AlexeyRevinski/RICNU_HLCI_board/RICNU_Plan_v_1_0.kicad_pcb

## KiCad design RICNU_Plan_v_1_0.kicad_pcb (2018-02-20)

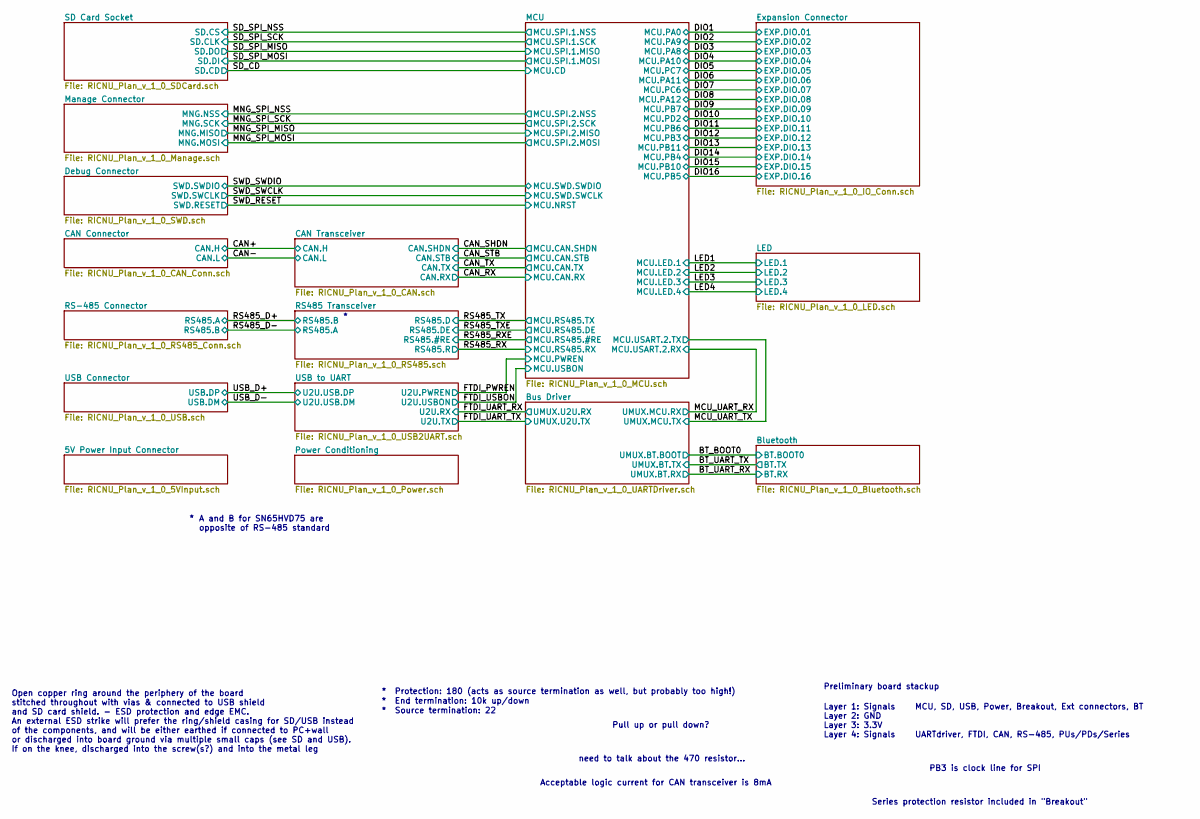
[picture p1: schematic RICNU_Plan_v_1_0.sch, RICNU Plan - Main]

Notes on the sheet:
Pull up or pull down?
* Protection: 180 (acts as source termination as well, but probably too high!)
* End termination: 10k up/down
* Source termination: 22
Acceptable logic current for CAN transceiver is 8mA
Series protection resistor included in "Breakout"
need to talk about the 470 resistor...
Open copper ring around the periphery of the board stitched throughout with vias & connected to USB shield and SD card shield. - ESD protection and edge EMC. An external ESD strike will prefer the ring/shield casing for SD/USB instead of the components, and will be either earthed if connected to PC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
PB3 is clock line for SPI
Layer 1: Signals Layer 2: GND Layer 3: 3.3V Layer 4: Signals
MCU, SD, USB, Power, Breakout, Ext connectors, BT UARTdriver, FTDI, CAN, RS-485, PUs/PDs/Series
Preliminary board stackup
A and B for SN65HVD75 are opposite of RS-485 standard

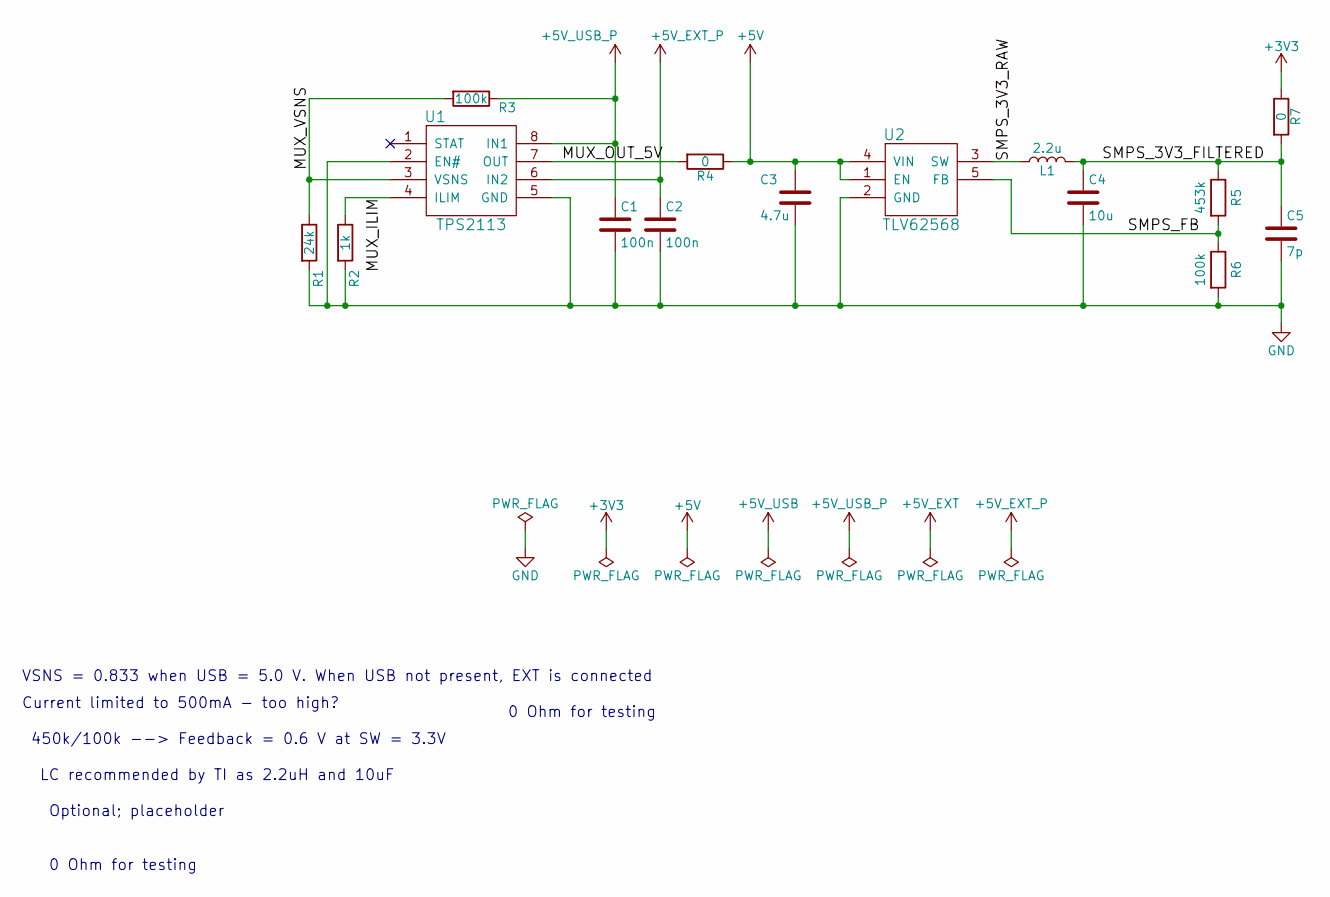
[picture p2: schematic RICNU_Plan_v_1_0_Power.sch, RICNU Plan - Main]

Parts:
C1, C2: 100n; C_0402_NoSilk
C3: 4.7u; C_0805
C4: 10u; C_0805
C5: 7p; C_0402_NoSilk
L1: 2.2u; L_Taiyo-Yuden_NR-50xx_HandSoldering
R1: 24k; R_0402_NoSilk
R2: 1k; R_0402_NoSilk
R3, R6: 100k; R_0402_NoSilk
R4, R7: 0; R_0402_NoSilk
R5: 453k; R_0402_NoSilk
U1: TPS2113; TSSOP-8_4.4x3mm_Pitch0.65mm
U2: TLV62568; SOT-23-5

Connections:
+3V3: R7.1; also elsewhere on the board
+5V: C3.1, R4.1, U2.1 (EN), U2.4 (VIN)
+5V_EXT_P: C2.1, U1.6 (IN2); also elsewhere on the board
+5V_USB_P: C1.1, R3.1, U1.8 (IN1); also elsewhere on the board
/Power Conditioning/MUX_ILIM: R2.1, U1.4 (ILIM)
/Power Conditioning/MUX_OUT_5V: R4.2, U1.7 (OUT)
/Power Conditioning/MUX_VSNS: R1.1, R3.2, U1.3 (VSNS)
/Power Conditioning/SMPS_3V3_FILTERED: C4.1, C5.1, L1.2, R5.1, R7.2
/Power Conditioning/SMPS_3V3_RAW: L1.1, U2.3 (SW)
/Power Conditioning/SMPS_FB: R5.2, R6.1, U2.5 (FB)
GND: C1.2, C2.2, C3.2, C4.2, C5.2, R1.2, R2.2, R6.2, U1.2 (EN#), U1.5 (GND), U2.2 (GND); also elsewhere on the board

Notes on the sheet:
0 Ohm for testing
450k/100k --> Feedback = 0.6 V at SW = 3.3V
LC recommended by TI as 2.2uH and 10uF
Optional; placeholder
VSNS = 0.833 when USB = 5.0 V. When USB not present, EXT is connected
Current limited to 500mA - too high?

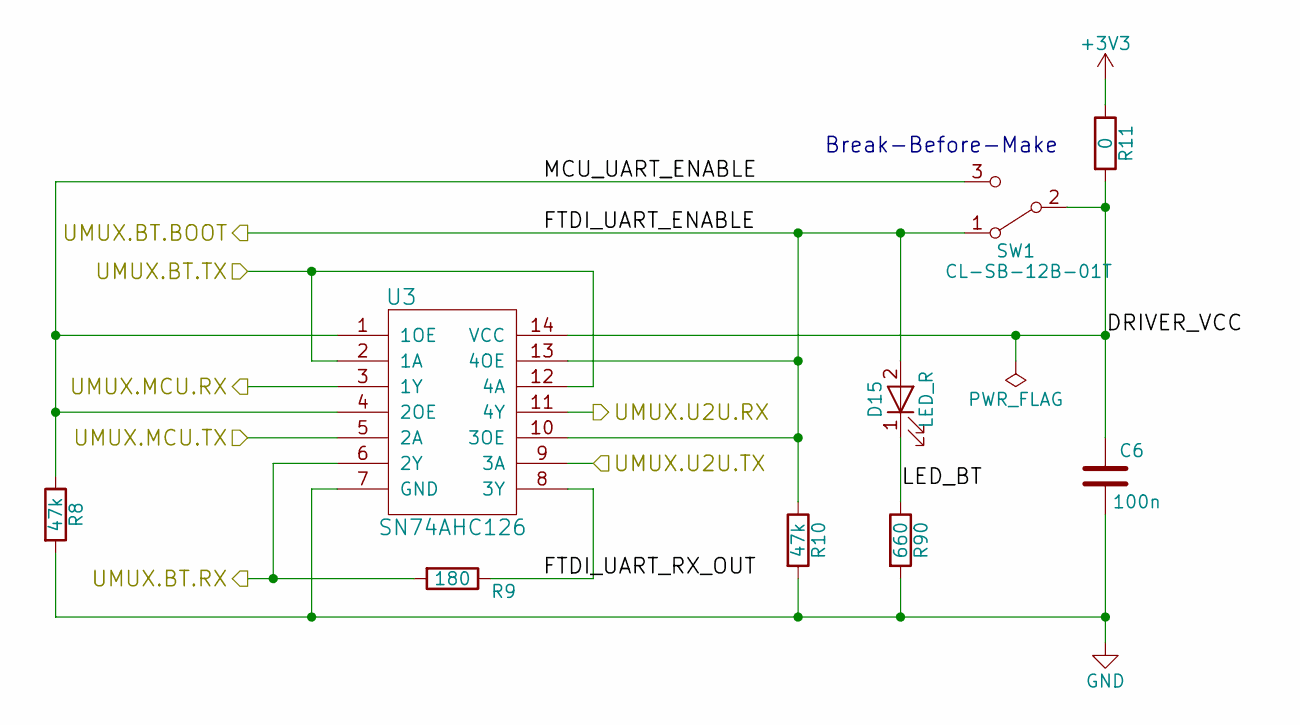
[picture p3: schematic RICNU_Plan_v_1_0_UARTDriver.sch, RICNU Plan - Main]

Parts:
C6: 100n; C_0402_NoSilk
D15: LED_R; LED_0402
R8, R10: 47k; R_0402_NoSilk
R9: 180; R_0402_NoSilk
R11: 0; R_0402_NoSilk
R90: 660; R_0402_NoSilk
SW1: CL-SB-12B-01T
U3: SN74AHC126; TSSOP-14_4.4x5mm_Pitch0.65mm

Connections:
+3V3: R11.1; also elsewhere on the board
/BT_BOOT0: D15.2 (A), R10.1, SW1.1 (A), U3.10 (3OE), U3.13 (4OE); also elsewhere on the board
/BT_UART_RX: R9.2, U3.6 (2Y); also elsewhere on the board
/BT_UART_TX: U3.2 (1A), U3.12 (4A); also elsewhere on the board
/Bus Driver/DRIVER_VCC: C6.1, R11.2, SW1.2 (B), U3.14 (VCC)
/Bus Driver/FTDI_UART_RX_OUT: R9.1, U3.8 (3Y)
/Bus Driver/LED_BT: D15.1 (K), R90.1
/Bus Driver/MCU_UART_ENABLE: R8.1, SW1.3 (C), U3.1 (1OE), U3.4 (2OE)
/FTDI_UART_RX: U3.11 (4Y); also elsewhere on the board
/FTDI_UART_TX: U3.9 (3A); also elsewhere on the board
/MCU_UART_RX: U3.3 (1Y); also elsewhere on the board
/MCU_UART_TX: U3.5 (2A); also elsewhere on the board
GND: C6.2, R8.2, R10.2, R90.2, U3.7 (GND); also elsewhere on the board

Notes on the sheet:
Break-Before-Make

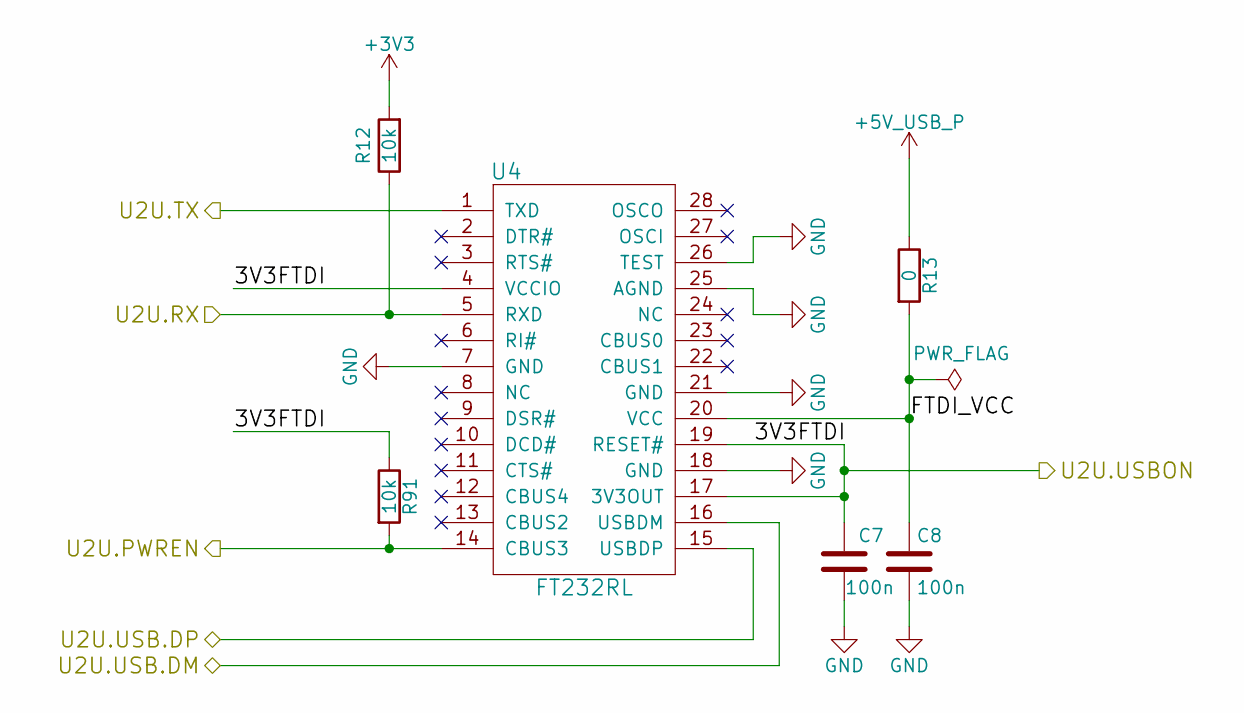
[picture p4: schematic RICNU_Plan_v_1_0_USB2UART.sch, RICNU Plan - Main]

Parts:
C7, C8: 100n; C_0402_NoSilk
R12, R91: 10k; R_0402_NoSilk
R13: 0; R_0402_NoSilk
U4: FT232RL; SSOP-28_5.3x10.2mm_Pitch0.65mm

Connections:
+3V3: R12.2; also elsewhere on the board
+5V_USB_P: R13.1; also elsewhere on the board
/FTDI_PWREN: R91.2, U4.14 (CBUS3); also elsewhere on the board
/FTDI_UART_RX: R12.1, U4.5 (RXD); also elsewhere on the board
/FTDI_UART_TX: U4.1 (TXD); also elsewhere on the board
/FTDI_USBON: C7.1, R91.1, U4.4 (VCCIO), U4.17 (3V3OUT), U4.19 (RESET#); also elsewhere on the board
/USB to UART/FTDI_VCC: C8.1, R13.2, U4.20 (VCC)
/USB_D+: U4.15 (USBDP); also elsewhere on the board
/USB_D-: U4.16 (USBDM); also elsewhere on the board
GND: C7.2, C8.2, U4.7 (GND), U4.18 (GND), U4.21 (GND), U4.25 (AGND), U4.26 (TEST); also elsewhere on the board

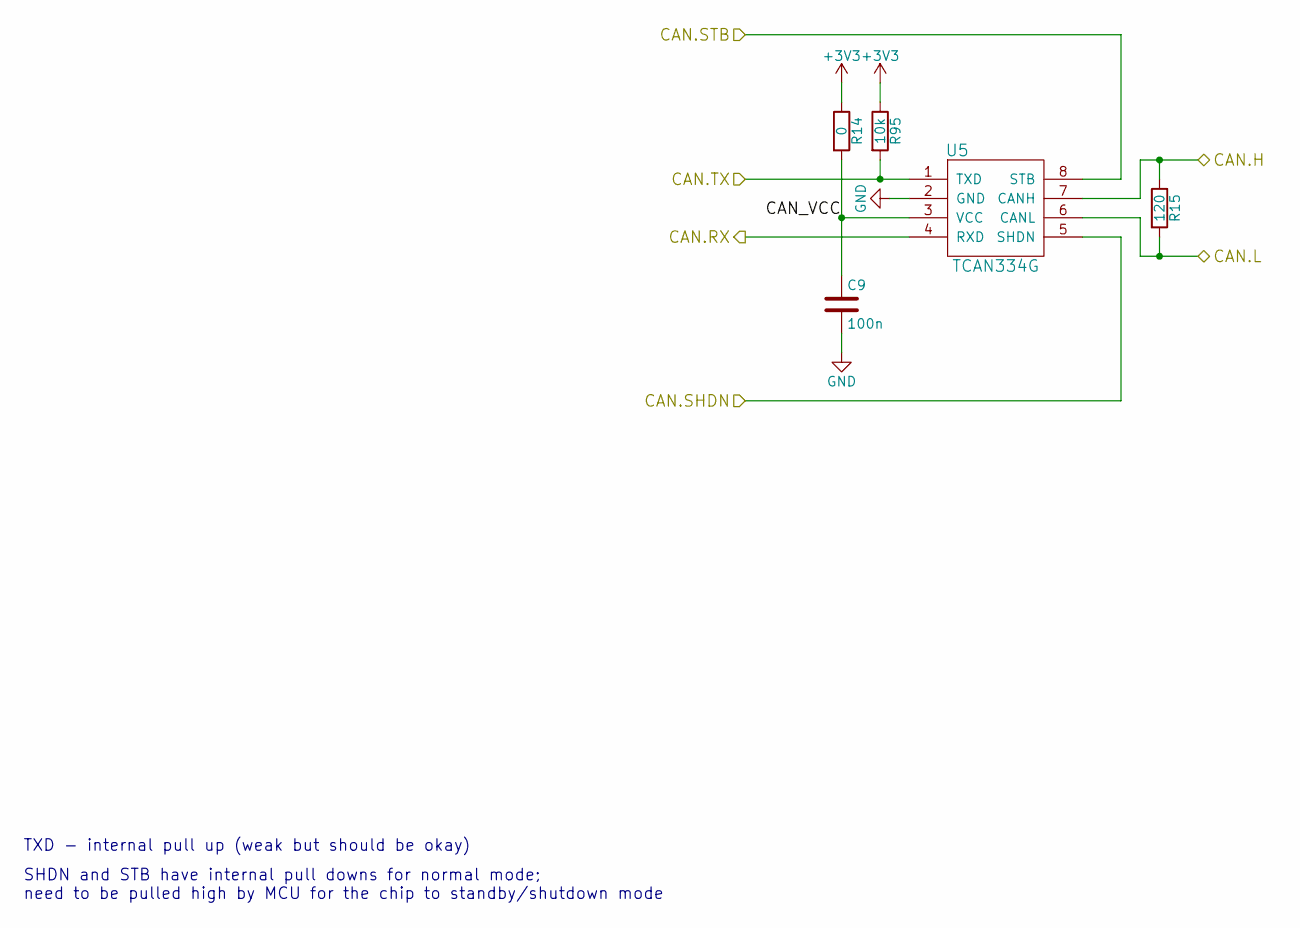
[picture p5: schematic RICNU_Plan_v_1_0_CAN.sch, RICNU Plan - Main]

Parts:
C9: 100n; C_0402_NoSilk
R14: 0; R_0402_NoSilk
R15: 120; R_0402_NoSilk
R95: 10k; R_0402_NoSilk
U5: TCAN334G; SOT-23-8

Connections:
+3V3: R14.1, R95.1; also elsewhere on the board
/CAN Transceiver/CAN_VCC: C9.1, R14.2, U5.3 (VCC)
/CAN+: R15.1, U5.7 (CANH); also elsewhere on the board
/CAN-: R15.2, U5.6 (CANL); also elsewhere on the board
/CAN_RX: U5.4 (RXD); also elsewhere on the board
/CAN_SHDN: U5.5 (SHDN); also elsewhere on the board
/CAN_STB: U5.8 (STB); also elsewhere on the board
/CAN_TX: R95.2, U5.1 (TXD); also elsewhere on the board
GND: C9.2, U5.2 (GND); also elsewhere on the board

Notes on the sheet:
SHDN and STB have internal pull downs for normal mode; need to be pulled high by MCU for the chip to standby/shutdown mode
TXD - internal pull up (weak but should be okay)

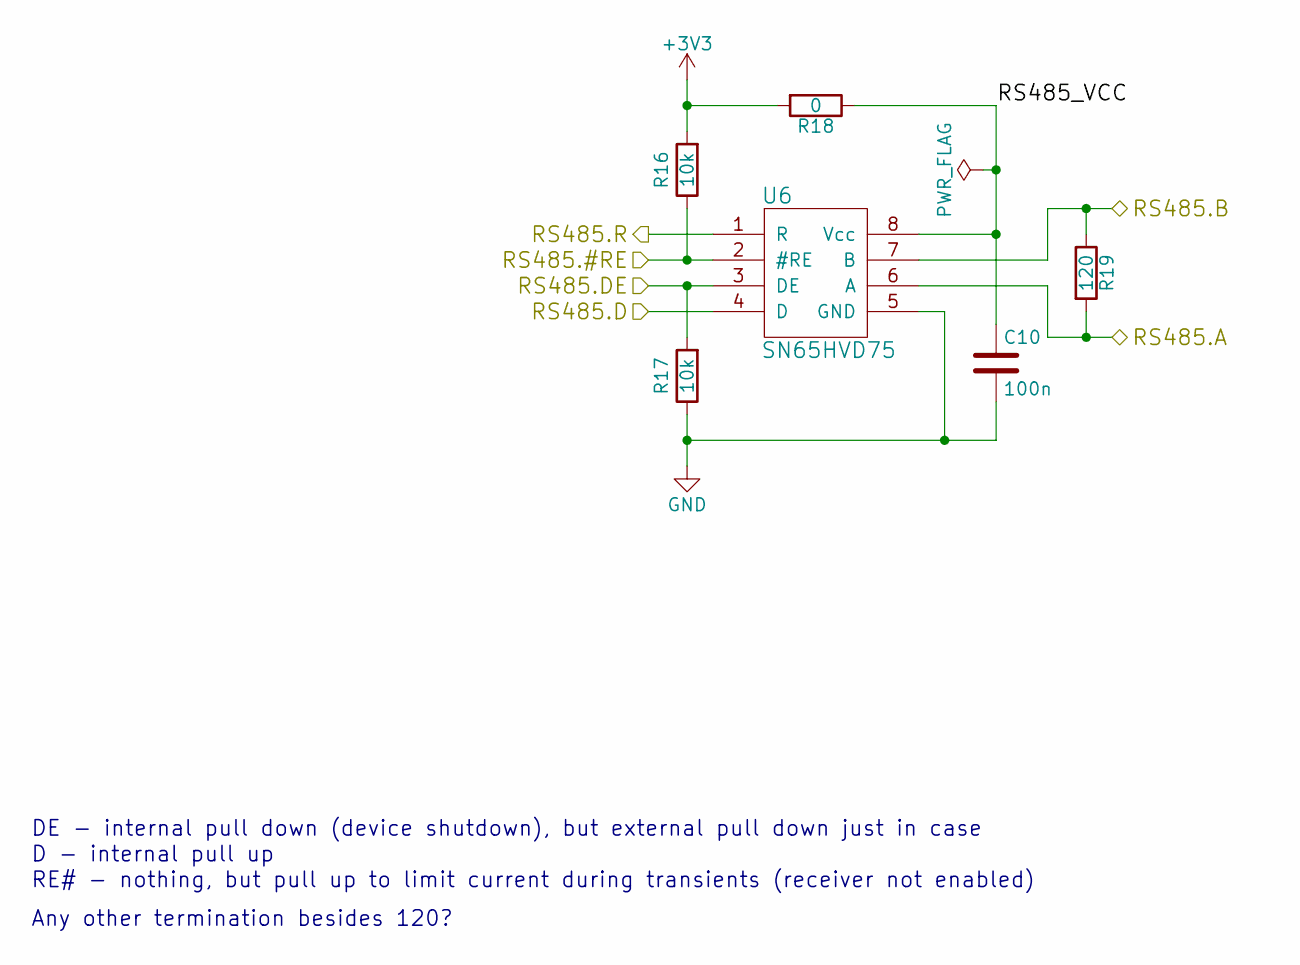
[picture p6: schematic RICNU_Plan_v_1_0_RS485.sch, RICNU Plan - Main]

Parts:
C10: 100n; C_0402_NoSilk
R16, R17: 10k; R_0402_NoSilk
R18: 0; R_0402_NoSilk
R19: 120; R_0402_NoSilk
U6: SN65HVD75; VSSOP-8_3.0x3.0mm_Pitch0.65mm

Connections:
+3V3: R16.2, R18.2; also elsewhere on the board
/RS485 Transceiver/RS485_VCC: C10.1, R18.1, U6.8 (Vcc)
/RS485_D+: R19.1, U6.7 (B); also elsewhere on the board
/RS485_D-: R19.2, U6.6 (A); also elsewhere on the board
/RS485_RX: U6.1 (R); also elsewhere on the board
/RS485_RXE: R16.1, U6.2 (#RE); also elsewhere on the board
/RS485_TX: U6.4 (D); also elsewhere on the board
/RS485_TXE: R17.2, U6.3 (DE); also elsewhere on the board
GND: C10.2, R17.1, U6.5 (GND); also elsewhere on the board

Notes on the sheet:
DE - internal pull down (device shutdown), but external pull down just in case
D - internal pull up
RE# - nothing, but pull up to limit current during transients (receiver not enabled)
Any other termination besides 120?

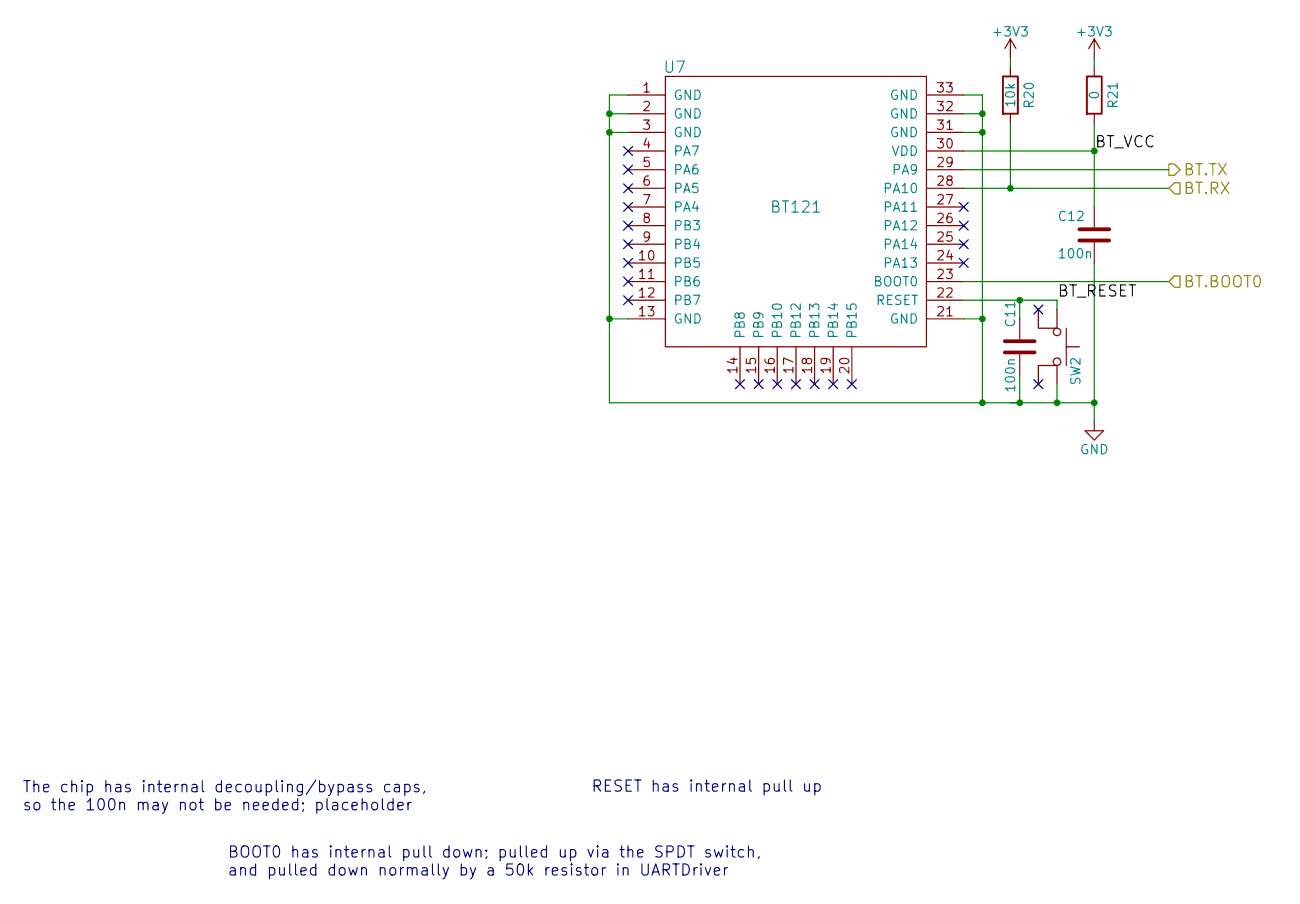
[picture p7: schematic RICNU_Plan_v_1_0_Bluetooth.sch, RICNU Plan - Main]

Parts:
C11, C12: 100n; C_0402_NoSilk
R20: 10k; R_0402_NoSilk
R21: 0; R_0402_NoSilk
SW2: SW_Push_4pin; SW_SPST_KMR7
U7: BT121; BT121-A

Connections:
+3V3: R20.1, R21.1; also elsewhere on the board
/BT_BOOT0: U7.23 (BOOT0); also elsewhere on the board
/BT_UART_RX: R20.2, U7.28 (PA10); also elsewhere on the board
/BT_UART_TX: U7.29 (PA9); also elsewhere on the board
/Bluetooth/BT_RESET: C11.1, SW2.1, U7.22 (RESET)
/Bluetooth/BT_VCC: C12.1, R21.2, U7.30 (VDD)
GND: C11.2, C12.2, SW2.2, U7.1 (GND), U7.2 (GND), U7.3 (GND), U7.13 (GND), U7.21 (GND), U7.31 (GND), U7.32 (GND), U7.33 (GND); also elsewhere on the board

Notes on the sheet:
BOOT0 has internal pull down; pulled up via the SPDT switch, and pulled down normally by a 50k resistor in UARTDriver
RESET has internal pull up
The chip has internal decoupling/bypass caps, so the 100n may not be needed; placeholder

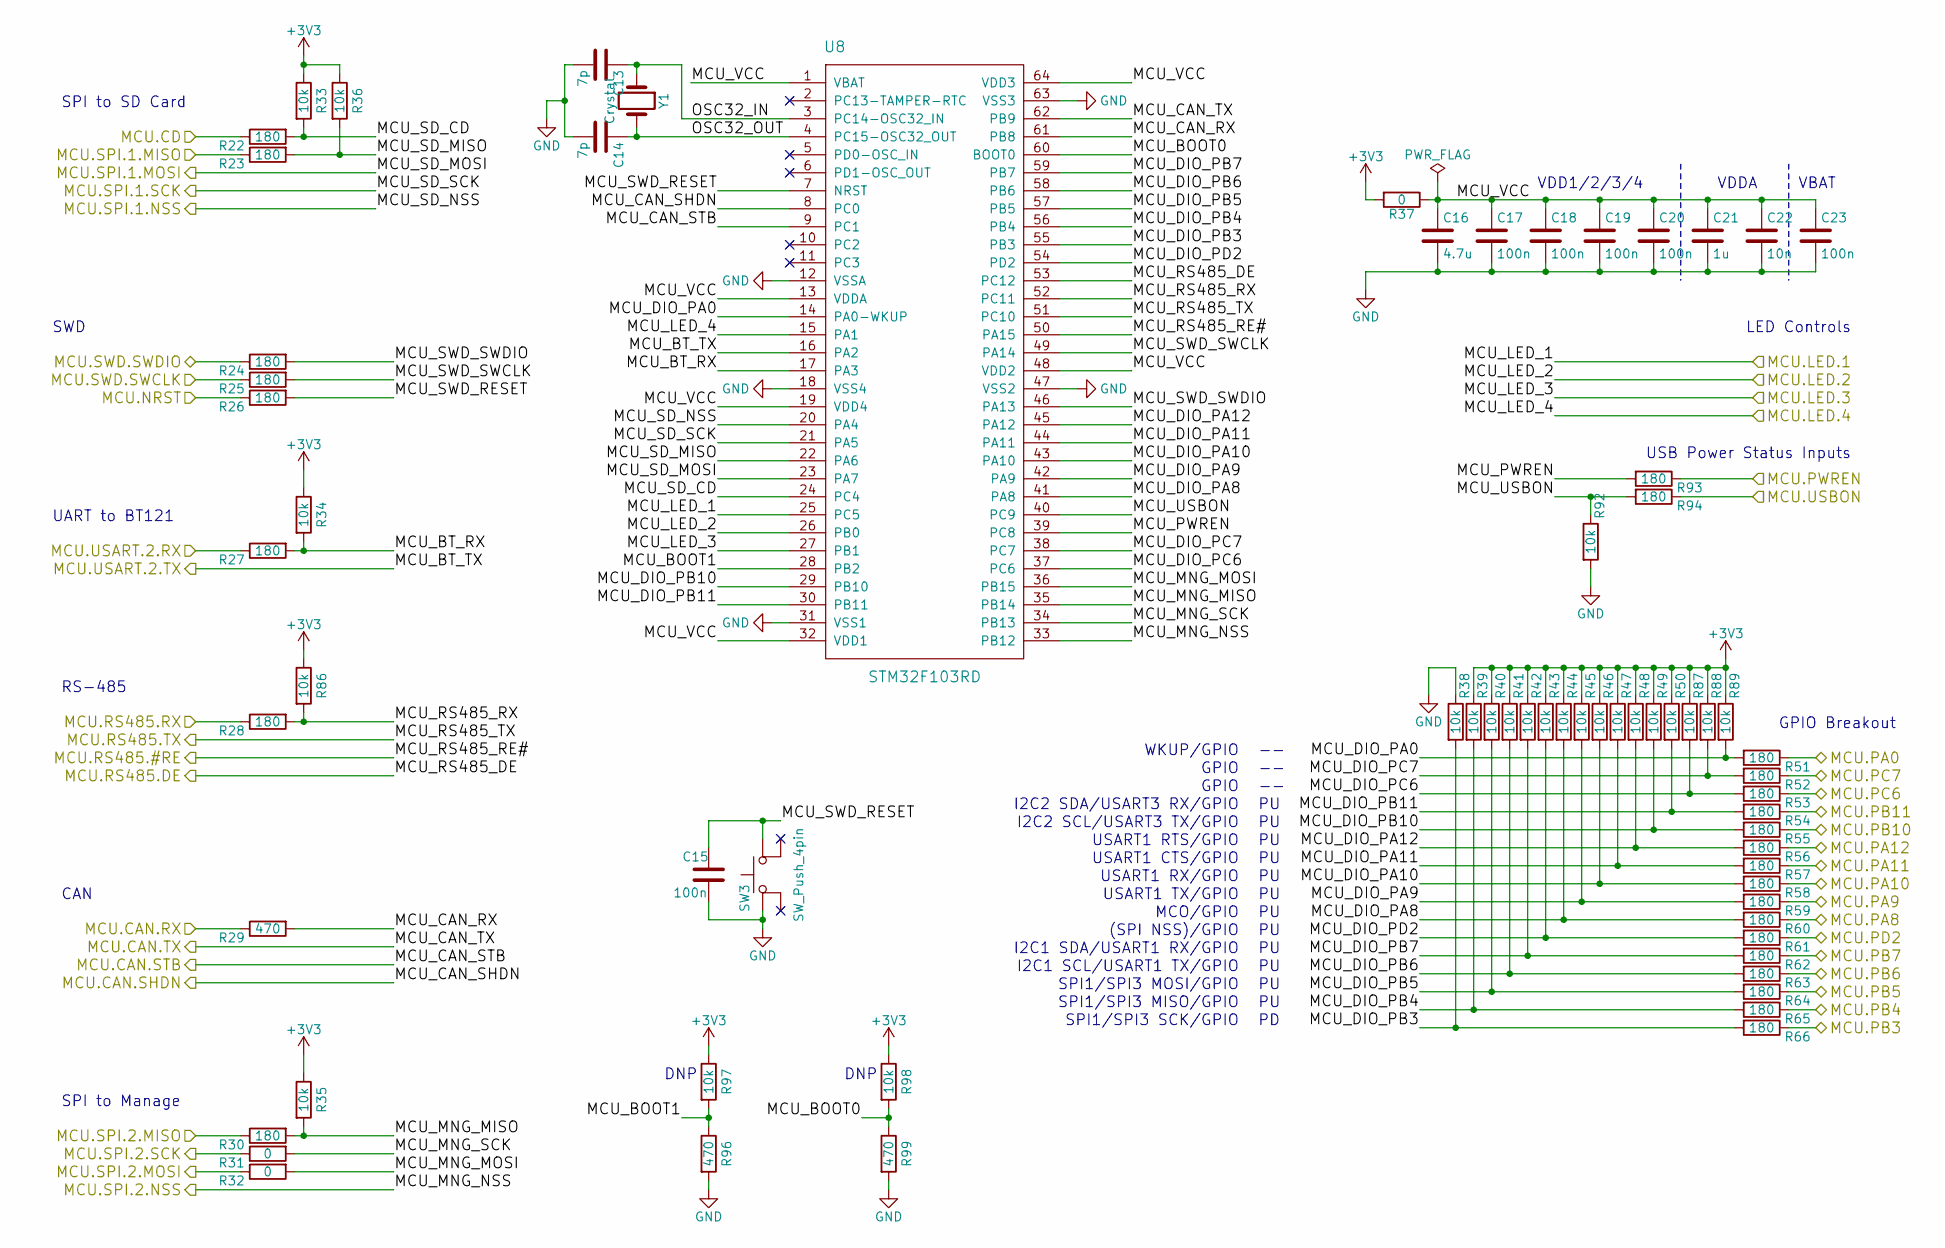
[picture p8: schematic RICNU_Plan_v_1_0_MCU.sch, RICNU Plan - Main]

Parts:
C13, C14: 7p; C_0402_NoSilk
C15, C17, C18, C19, C20, C23: 100n; C_0402_NoSilk
C16: 4.7u; C_0805
C21: 1u; C_0805
C22: 10n; C_0402_NoSilk
R22, R23, R24, R25, R26, R27, R28, R30, R51, R52, R53, R54, R55, R56, R57, R58, R59, R60, R61, R62, R63, R64, R65, R66, R93, R94: 180; R_0402_NoSilk
R29, R96, R99: 470; R_0402_NoSilk
R31, R32, R37: 0; R_0402_NoSilk
R33, R34, R35, R36, R38, R39, R40, R41, R42, R43, R44, R45, R46, R47, R48, R49, R50, R86, R87, R88, R89, R92, R97, R98: 10k; R_0402_NoSilk
SW3: SW_Push_4pin; SW_SPST_KMR7
U8: STM32F103RD; TQFP-64_10x10mm_Pitch0.5mm
Y1: Crystal; Crystal_SMD_3215-2pin_3.2x1.5mm

Connections:
+3V3: R33.1, R34.1, R35.1, R36.1, R37.2, R39.1, R40.1, R41.1, R42.1, R43.1, R44.1, R45.1, R46.1, R47.1, R48.1, R49.1, R50.1, R86.1, R87.1, R88.1, R89.1, R97.1, R98.1; also elsewhere on the board
/CAN_RX: R29.1; also elsewhere on the board
/CAN_SHDN: U8.8 (PC0); also elsewhere on the board
/CAN_STB: U8.9 (PC1); also elsewhere on the board
/CAN_TX: U8.62 (PB9); also elsewhere on the board
/DIO1: R51.1; also elsewhere on the board
/DIO2: R59.1; also elsewhere on the board
/DIO3: R60.1; also elsewhere on the board
/DIO4: R58.1; also elsewhere on the board
/DIO5: R52.1; also elsewhere on the board
/DIO6: R57.1; also elsewhere on the board
/DIO7: R53.1; also elsewhere on the board
/DIO8: R56.1; also elsewhere on the board
/DIO9: R62.1; also elsewhere on the board
/DIO10: R61.1; also elsewhere on the board
/DIO11: R63.1; also elsewhere on the board
/DIO12: R66.1; also elsewhere on the board
/DIO13: R54.1; also elsewhere on the board
/DIO14: R65.1; also elsewhere on the board
/DIO15: R55.1; also elsewhere on the board
/DIO16: R64.1; also elsewhere on the board
/FTDI_PWREN: R93.1; also elsewhere on the board
/FTDI_USBON: R94.1; also elsewhere on the board
/LED1: U8.25 (PC5); also elsewhere on the board
/LED2: U8.26 (PB0); also elsewhere on the board
/LED3: U8.27 (PB1); also elsewhere on the board
/LED4: U8.15 (PA1); also elsewhere on the board
/MCU/MCU_BOOT0: R98.2, R99.1, U8.60 (BOOT0)
/MCU/MCU_BOOT1: R96.1, R97.2, U8.28 (PB2)
/MCU/MCU_BT_RX: R27.2, R34.2, U8.17 (PA3)
/MCU/MCU_CAN_RX: R29.2, U8.61 (PB8)
/MCU/MCU_DIO_PA0: R51.2, R89.2, U8.14 (PA0-WKUP)
/MCU/MCU_DIO_PA8: R44.2, R60.2, U8.41 (PA8)
/MCU/MCU_DIO_PA9: R45.2, R59.2, U8.42 (PA9)
/MCU/MCU_DIO_PA10: R46.2, R58.2, U8.43 (PA10)
/MCU/MCU_DIO_PA11: R47.2, R57.2, U8.44 (PA11)
/MCU/MCU_DIO_PA12: R48.2, R56.2, U8.45 (PA12)
/MCU/MCU_DIO_PB3: R38.2, R66.2, U8.55 (PB3)
/MCU/MCU_DIO_PB4: R39.2, R65.2, U8.56 (PB4)
/MCU/MCU_DIO_PB5: R40.2, R64.2, U8.57 (PB5)
/MCU/MCU_DIO_PB6: R41.2, R63.2, U8.58 (PB6)
/MCU/MCU_DIO_PB7: R42.2, R62.2, U8.59 (PB7)
/MCU/MCU_DIO_PB10: R49.2, R55.2, U8.29 (PB10)
/MCU/MCU_DIO_PB11: R50.2, R54.2, U8.30 (PB11)
/MCU/MCU_DIO_PC6: R53.2, R87.2, U8.37 (PC6)
/MCU/MCU_DIO_PC7: R52.2, R88.2, U8.38 (PC7)
/MCU/MCU_DIO_PD2: R43.2, R61.2, U8.54 (PD2)
/MCU/MCU_MNG_MISO: R30.2, R35.2, U8.35 (PB14)
/MCU/MCU_MNG_MOSI: R32.2, U8.36 (PB15)
/MCU/MCU_MNG_SCK: R31.2, U8.34 (PB13)
/MCU/MCU_PWREN: R93.2, U8.39 (PC8)
/MCU/MCU_RS485_RX: R28.2, R86.2, U8.52 (PC11)
/MCU/MCU_SD_CD: R22.2, R33.2, U8.24 (PC4)
/MCU/MCU_SD_MISO: R23.2, R36.2, U8.22 (PA6)
/MCU/MCU_SWD_RESET: C15.1, R26.2, SW3.1, U8.7 (NRST)
/MCU/MCU_SWD_SWCLK: R25.2, U8.49 (PA14)
/MCU/MCU_SWD_SWDIO: R24.2, U8.46 (PA13)
/MCU/MCU_USBON: R92.1, R94.2, U8.40 (PC9)
/MCU/MCU_VCC: C16.1, C17.1, C18.1, C19.1, C20.1, C21.1, C22.1, C23.1, R37.1, U8.1 (VBAT), U8.13 (VDDA), U8.19 (VDD4), U8.32 (VDD1), U8.48 (VDD2), U8.64 (VDD3)
/MCU/OSC32_IN: C13.1, U8.3 (PC14-OSC32_IN), Y1.1
/MCU/OSC32_OUT: C14.1, U8.4 (PC15-OSC32_OUT), Y1.2
/MCU_UART_RX: R27.1; also elsewhere on the board
/MCU_UART_TX: U8.16 (PA2); also elsewhere on the board
/MNG_SPI_MISO: R30.1; also elsewhere on the board
/MNG_SPI_MOSI: R32.1; also elsewhere on the board
/MNG_SPI_NSS: U8.33 (PB12); also elsewhere on the board
/MNG_SPI_SCK: R31.1; also elsewhere on the board
/RS485_RX: R28.1; also elsewhere on the board
/RS485_RXE: U8.50 (PA15); also elsewhere on the board
/RS485_TX: U8.51 (PC10); also elsewhere on the board
/RS485_TXE: U8.53 (PC12); also elsewhere on the board
/SD_CD: R22.1; also elsewhere on the board
/SD_SPI_MISO: R23.1; also elsewhere on the board
/SD_SPI_MOSI: U8.23 (PA7); also elsewhere on the board
/SD_SPI_NSS: U8.20 (PA4); also elsewhere on the board
/SD_SPI_SCK: U8.21 (PA5); also elsewhere on the board
/SWD_RESET: R26.1; also elsewhere on the board
/SWD_SWCLK: R25.1; also elsewhere on the board
/SWD_SWDIO: R24.1; also elsewhere on the board
GND: C13.2, C14.2, C15.2, C16.2, C17.2, C18.2, C19.2, C20.2, C21.2, C22.2, C23.2, R38.1, R92.2, R96.2, R99.2, SW3.2, U8.12 (VSSA), U8.18 (VSS4), U8.31 (VSS1), U8.47 (VSS2), U8.63 (VSS3); also elsewhere on the board

Notes on the sheet:
VBAT
VDDA
VDD1/2/3/4
CAN
SPI to Manage
RS-485
UART to BT121
SWD
SPI to SD Card
SPI1/SPI3 SCK/GPIO
SPI1/SPI3 MISO/GPIO
SPI1/SPI3 MOSI/GPIO
I2C1 SCL/USART1 TX/GPIO
I2C1 SDA/USART1 RX/GPIO
(SPI NSS)/GPIO
MCO/GPIO
USART1 TX/GPIO
USART1 RX/GPIO
USART1 CTS/GPIO
USART1 RTS/GPIO
I2C2 SCL/USART3 TX/GPIO
I2C2 SDA/USART3 RX/GPIO
GPIO
WKUP/GPIO
GPIO Breakout
LED Controls
USB Power Status Inputs
DNP

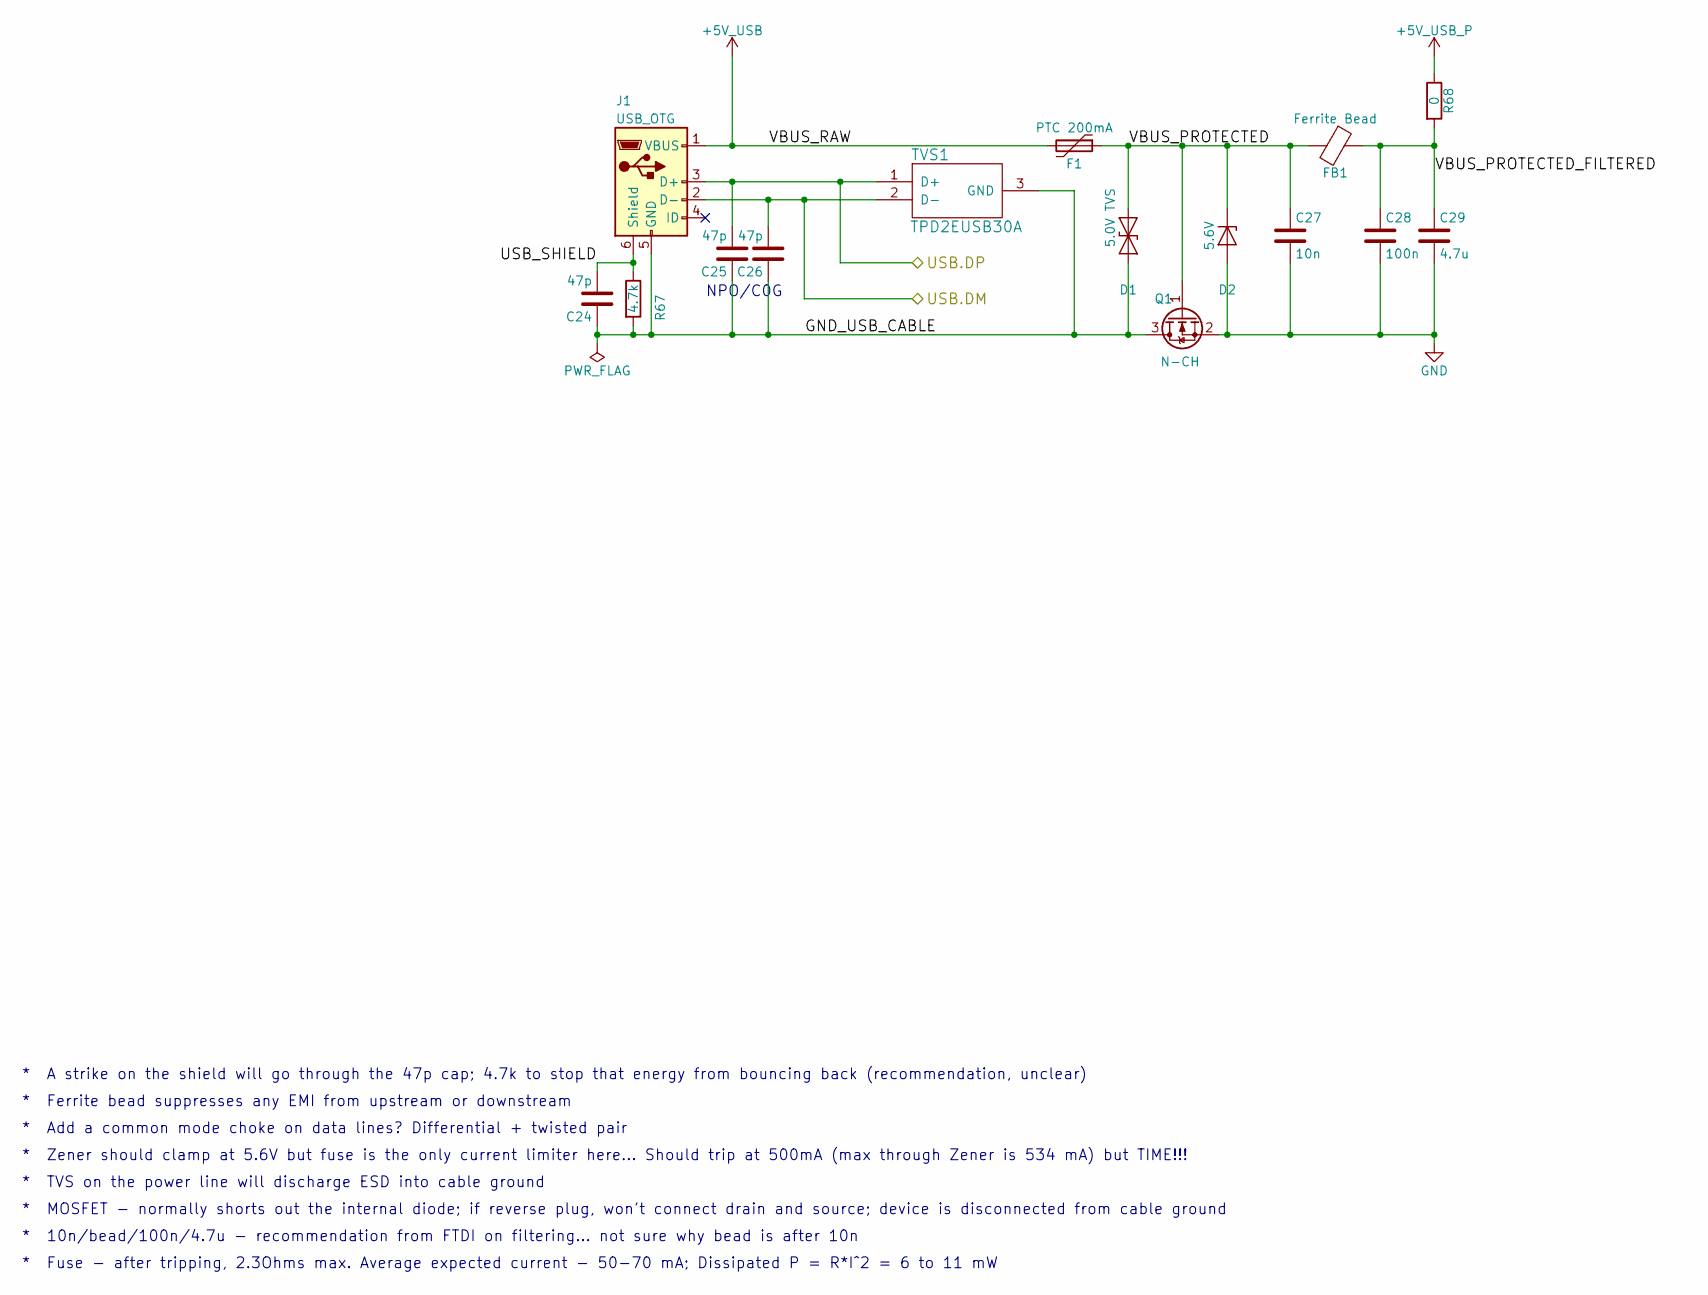
[picture p9: schematic RICNU_Plan_v_1_0_USB.sch, RICNU Plan - Main]

Parts:
C24, C25, C26: 47p; C_0402_NoSilk
C27: 10n; C_0402_NoSilk
C28: 100n; C_0402_NoSilk
C29: 4.7u; C_0805
D1: 5.0V TVS; D_SOD-523
D2: 5.6V; D_SMA_Handsoldering
F1: PTC 200mA; R_0603_HandSoldering
FB1: Ferrite Bead; R_0402_NoSilk
J1: USB_OTG; USB_Micro-B_Molex-105017-0001
Q1: N-CH; SOT-23
R67: 4.7k; R_0402_NoSilk
R68: 0; R_0402_NoSilk
TVS1: TPD2EUSB30A; Texas_DRT-3

Connections:
+5V_USB: F1.2, J1.1 (VBUS)
+5V_USB_P: R68.1; also elsewhere on the board
/USB Connector/GND_USB_CABLE: C24.1, C25.1, C26.1, D1.2 (A2), J1.5 (GND), Q1.3 (D), R67.2, TVS1.3 (GND)
/USB Connector/USB_SHIELD: C24.2, J1.6 (Shield), R67.1
/USB Connector/VBUS_PROTECTED: C27.1, D1.1 (A1), D2.1 (K), F1.1, FB1.2, Q1.1 (G)
/USB Connector/VBUS_PROTECTED_FILTERED: C28.1, C29.1, FB1.1, R68.2
/USB_D+: C25.2, J1.3 (D+), TVS1.1 (D+); also elsewhere on the board
/USB_D-: C26.2, J1.2 (D-), TVS1.2 (D-); also elsewhere on the board
GND: C27.2, C28.2, C29.2, D2.2 (A), Q1.2 (S); also elsewhere on the board

Notes on the sheet:
* A strike on the shield will go through the 47p cap; 4.7k to stop that energy from bouncing back (recommendation, unclear)
* Ferrite bead suppresses any EMI from upstream or downstream
* Add a common mode choke on data lines? Differential + twisted pair
* Zener should clamp at 5.6V but fuse is the only current limiter here... Should trip at 500mA (max through Zener is 534 mA) but TIME!!!
* TVS on the power line will discharge ESD into cable ground
* MOSFET - normally shorts out the internal diode; if reverse plug, won't connect drain and source; device is disconnected from cable ground
* 10n/bead/100n/4.7u - recommendation from FTDI on filtering... not sure why bead is after 10n
* Fuse - after tripping, 2.3Ohms max. Average expected current - 50-70 mA; Dissipated P = R*I^2 = 6 to 11 mW
NPO/C0G

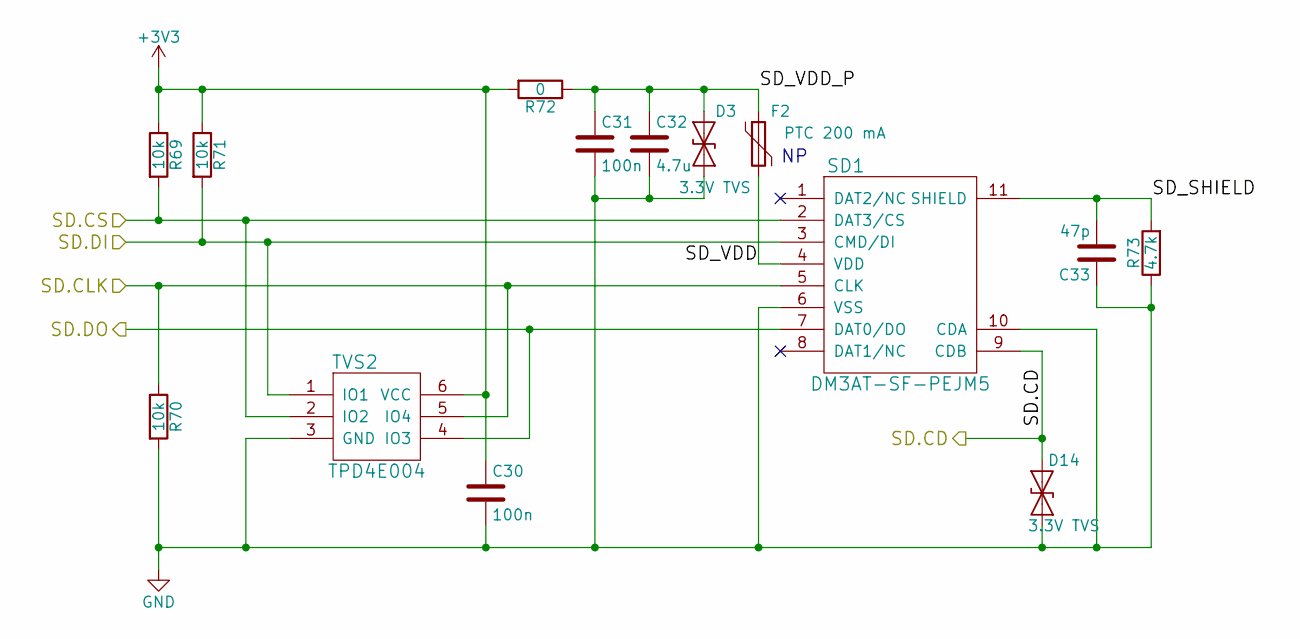
[picture p10: schematic RICNU_Plan_v_1_0_SDCard.sch, RICNU Plan - Main]

Parts:
C30, C31: 100n; C_0402_NoSilk
C32: 4.7u; C_0805
C33: 47p; C_0402_NoSilk
D3, D14: 3.3V TVS; D_SOD-523
F2: PTC 200 mA; R_0603_HandSoldering
R69, R70, R71: 10k; R_0402_NoSilk
R72: 0; R_0402_NoSilk
R73: 4.7k; R_0402_NoSilk
SD1: DM3AT-SF-PEJM5; Hirose_DM3AT-SF-PEJM5
TVS2: TPD4E004; Fairchild_MicroPak-6_1.0x1.45mm_Pitch0.5mm

Connections:
+3V3: C30.1, R69.1, R71.1, R72.2, TVS2.6 (VCC); also elsewhere on the board
/SD Card Socket/SD_SHIELD: C33.2, R73.2, SD1.11 (SHIELD)
/SD Card Socket/SD_VDD: F2.2, SD1.4 (VDD)
/SD Card Socket/SD_VDD_P: C31.1, C32.1, D3.1 (A1), F2.1, R72.1
/SD_CD: D14.1 (A1), SD1.9 (CDB); also elsewhere on the board
/SD_SPI_MISO: SD1.7 (DAT0/DO), TVS2.4 (IO3); also elsewhere on the board
/SD_SPI_MOSI: R71.2, SD1.3 (CMD/DI), TVS2.1 (IO1); also elsewhere on the board
/SD_SPI_NSS: R69.2, SD1.2 (DAT3/CS), TVS2.2 (IO2); also elsewhere on the board
/SD_SPI_SCK: R70.1, SD1.5 (CLK), TVS2.5 (IO4); also elsewhere on the board
GND: C30.2, C31.2, C32.2, C33.1, D3.2 (A2), D14.2 (A2), R70.2, R73.1, SD1.6 (VSS), SD1.10 (CDA), TVS2.3 (GND); also elsewhere on the board

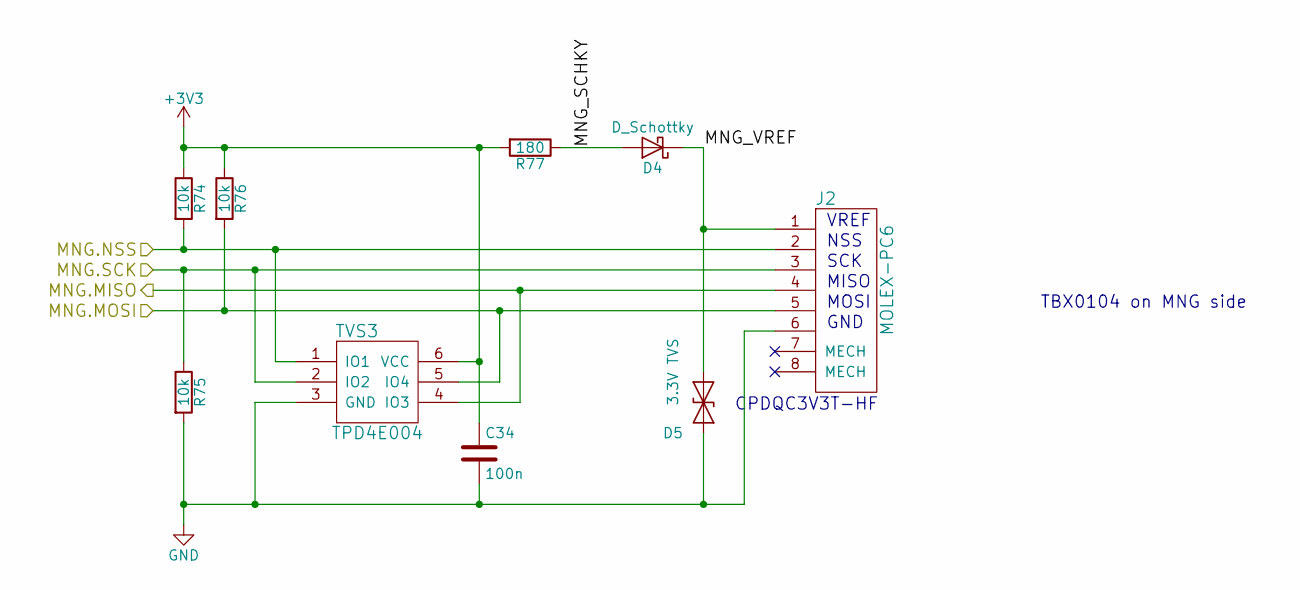
[picture p11: schematic RICNU_Plan_v_1_0_Manage.sch, RICNU Plan - Main]

Parts:
C34: 100n; C_0402_NoSilk
D4: D_Schottky; D_SOD-323
D5: 3.3V TVS; D_SOD-523
J2: MOLEX-PC6; Molex_PicoClasp_501568-0607_1x06_P1.0mm_RightAngle
R74, R75, R76: 10k; R_0402_NoSilk
R77: 180; R_0402_NoSilk
TVS3: TPD4E004; Fairchild_MicroPak-6_1.0x1.45mm_Pitch0.5mm

Connections:
+3V3: C34.1, R74.1, R76.1, R77.2, TVS3.6 (VCC); also elsewhere on the board
/MNG_SPI_MISO: J2.4, TVS3.4 (IO3); also elsewhere on the board
/MNG_SPI_MOSI: J2.5, R76.2, TVS3.5 (IO4); also elsewhere on the board
/MNG_SPI_NSS: J2.2, R74.2, TVS3.1 (IO1); also elsewhere on the board
/MNG_SPI_SCK: J2.3, R75.1, TVS3.2 (IO2); also elsewhere on the board
/Manage Connector/MNG_SCHKY: D4.2 (A), R77.1
/Manage Connector/MNG_VREF: D4.1 (K), D5.1 (A1), J2.1
GND: C34.2, D5.2 (A2), J2.6, R75.2, TVS3.3 (GND); also elsewhere on the board

Notes on the sheet:
CPDQC3V3T-HF
TBX0104 on MNG side
VREF
NSS
SCK
MISO
MOSI
GND
