AlexeyRevinski/RICNU_HLCI_board/RICNU_Plan_v_1_0.kicad_pcb

## KiCad design RICNU_Plan_v_1_0.kicad_pcb (continued)

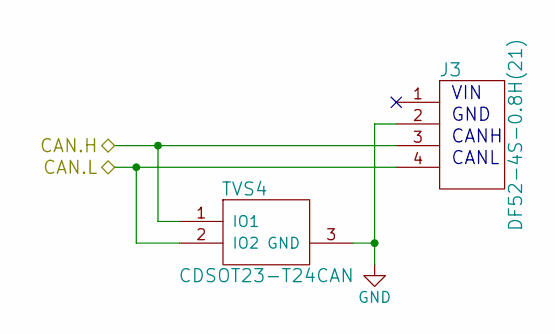
[picture p12: schematic RICNU_Plan_v_1_0_CAN_Conn.sch, RICNU Plan - Main]

Parts:
J3: DF52-4S-0.8H(21); Hirose_DF52-4S-0.8H_04x0.80mm_Angled
TVS4: CDSOT23-T24CAN; SOT-23

Connections:
/CAN+: J3.3, TVS4.1 (IO1); also elsewhere on the board
/CAN-: J3.4, TVS4.2 (IO2); also elsewhere on the board
GND: J3.2, TVS4.3 (GND); also elsewhere on the board

Notes on the sheet:
VIN
CANH
CANL
GND

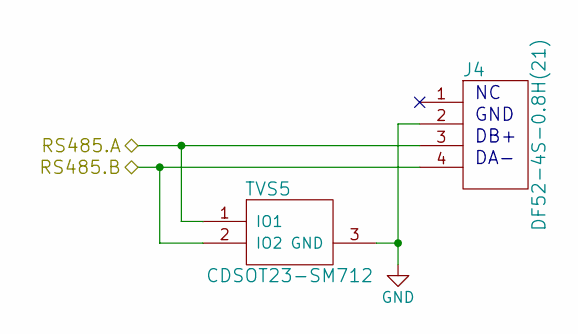
[picture p13: schematic RICNU_Plan_v_1_0_RS485_Conn.sch, RICNU Plan - Main]

Parts:
J4: DF52-4S-0.8H(21); Hirose_DF52-4S-0.8H_04x0.80mm_Angled
TVS5: CDSOT23-SM712; SOT-23

Connections:
/RS485_D+: J4.3, TVS5.1 (IO1); also elsewhere on the board
/RS485_D-: J4.4, TVS5.2 (IO2); also elsewhere on the board
GND: J4.2, TVS5.3 (GND); also elsewhere on the board

Notes on the sheet:
GND
DB+
DA-

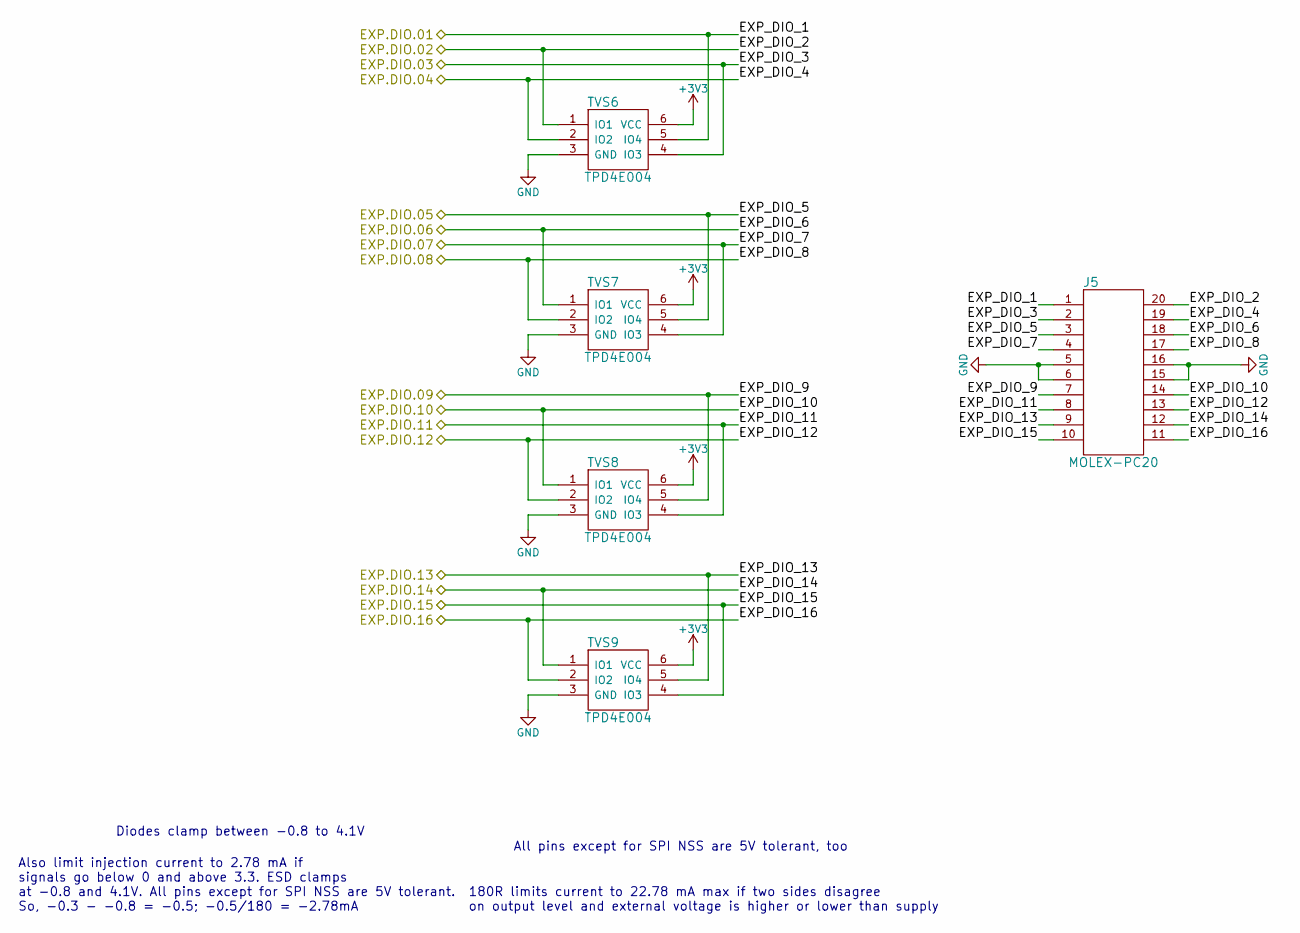
[picture p14: schematic RICNU_Plan_v_1_0_IO_Conn.sch, RICNU Plan - Main]

Parts:
J5: MOLEX-PC20; Molex_PicoClasp_501571-2007_2x10_P1.0mm_RightAngle
TVS6, TVS7, TVS8, TVS9: TPD4E004; Fairchild_MicroPak-6_1.0x1.45mm_Pitch0.5mm

Connections:
+3V3: TVS6.6 (VCC), TVS7.6 (VCC), TVS8.6 (VCC), TVS9.6 (VCC); also elsewhere on the board
/DIO1: J5.1, TVS6.5 (IO4); also elsewhere on the board
/DIO2: J5.20, TVS6.1 (IO1); also elsewhere on the board
/DIO3: J5.2, TVS6.4 (IO3); also elsewhere on the board
/DIO4: J5.19, TVS6.2 (IO2); also elsewhere on the board
/DIO5: J5.3, TVS7.5 (IO4); also elsewhere on the board
/DIO6: J5.18, TVS7.1 (IO1); also elsewhere on the board
/DIO7: J5.4, TVS7.4 (IO3); also elsewhere on the board
/DIO8: J5.17, TVS7.2 (IO2); also elsewhere on the board
/DIO9: J5.7, TVS8.5 (IO4); also elsewhere on the board
/DIO10: J5.14, TVS8.1 (IO1); also elsewhere on the board
/DIO11: J5.8, TVS8.4 (IO3); also elsewhere on the board
/DIO12: J5.13, TVS8.2 (IO2); also elsewhere on the board
/DIO13: J5.9, TVS9.5 (IO4); also elsewhere on the board
/DIO14: J5.12, TVS9.1 (IO1); also elsewhere on the board
/DIO15: J5.10, TVS9.4 (IO3); also elsewhere on the board
/DIO16: J5.11, TVS9.2 (IO2); also elsewhere on the board
GND: J5.5, J5.6, J5.15, J5.16, TVS6.3 (GND), TVS7.3 (GND), TVS8.3 (GND), TVS9.3 (GND); also elsewhere on the board

Notes on the sheet:
180R limits current to 22.78 mA max if two sides disagree on output level and external voltage is higher or lower than supply
Diodes clamp between -0.8 to 4.1V
Also limit injection current to 2.78 mA if signals go below 0 and above 3.3. ESD clamps at -0.8 and 4.1V. All pins except for SPI NSS are 5V tolerant. So, -0.3 - -0.8 = -0.5; -0.5/180 = -2.78mA
All pins except for SPI NSS are 5V tolerant, too

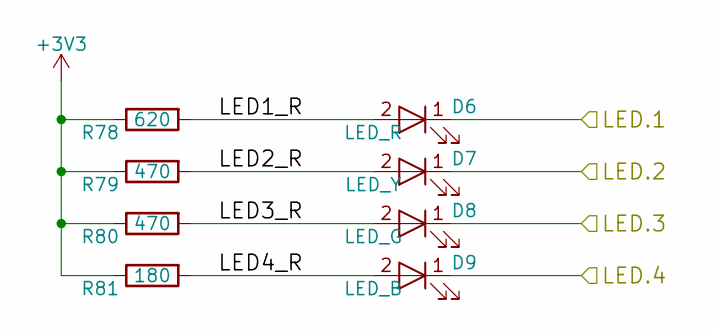
[picture p15: schematic RICNU_Plan_v_1_0_LED.sch, RICNU Plan - Main]

Parts:
D6: LED_R; LED_0402
D7: LED_Y; LED_0402
D8: LED_G; LED_0402
D9: LED_B; LED_0402
R78: 620; R_0402_NoSilk
R79, R80: 470; R_0402_NoSilk
R81: 180; R_0402_NoSilk

Connections:
+3V3: R78.1, R79.1, R80.1, R81.1; also elsewhere on the board
/LED1: D6.1 (K); also elsewhere on the board
/LED2: D7.1 (K); also elsewhere on the board
/LED3: D8.1 (K); also elsewhere on the board
/LED4: D9.1 (K); also elsewhere on the board
/LED/LED1_R: D6.2 (A), R78.2
/LED/LED2_R: D7.2 (A), R79.2
/LED/LED3_R: D8.2 (A), R80.2
/LED/LED4_R: D9.2 (A), R81.2

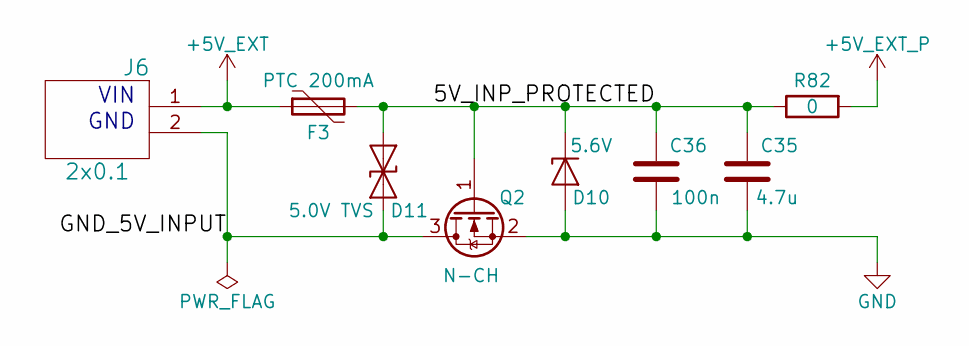
[picture p16: schematic RICNU_Plan_v_1_0_5VInput.sch, RICNU Plan - Main]

Parts:
C35: 4.7u; C_0805
C36: 100n; C_0402_NoSilk
D10: 5.6V; D_SMA_Handsoldering
D11: 5.0V TVS; D_SOD-523
F3: PTC 200mA; R_0603_HandSoldering
J6: 2x0.1; Pin_Header_Straight_1x02_Pitch2.54mm
Q2: N-CH; SOT-23
R82: 0; R_0402_NoSilk

Connections:
+5V_EXT: F3.1, J6.1
+5V_EXT_P: R82.2; also elsewhere on the board
/5V Power Input Connector/5V_INP_PROTECTED: C35.1, C36.1, D10.1 (K), D11.1 (A1), F3.2, Q2.1 (G), R82.1
/5V Power Input Connector/GND_5V_INPUT: D11.2 (A2), J6.2, Q2.3 (D)
GND: C35.2, C36.2, D10.2 (A), Q2.2 (S); also elsewhere on the board

Notes on the sheet:
VIN
GND

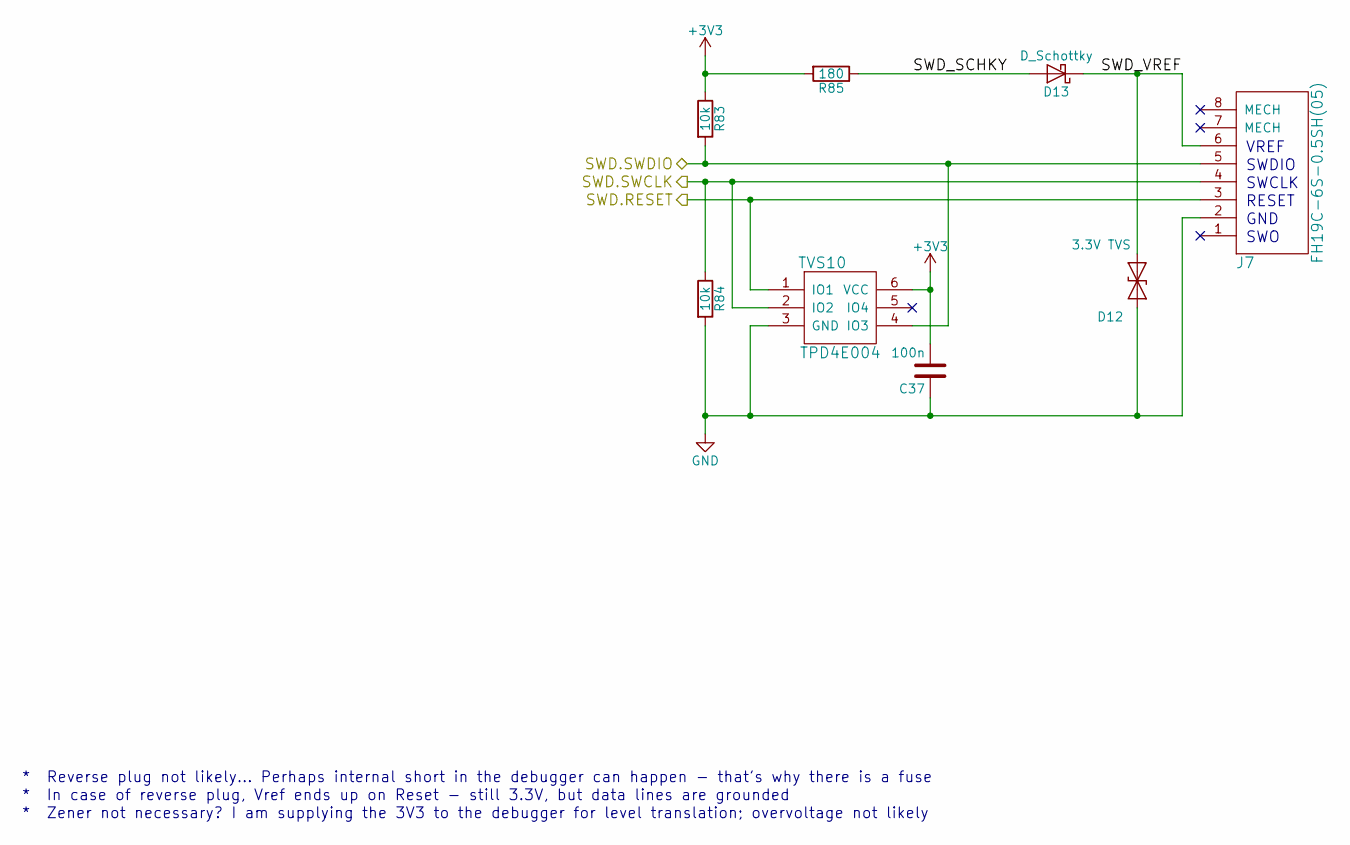
[picture p17: schematic RICNU_Plan_v_1_0_SWD.sch, RICNU Plan - Main]

Parts:
C37: 100n; C_0402_NoSilk
D12: 3.3V TVS; D_SOD-523
D13: D_Schottky; D_SOD-323
J7: FH19C-6S-0.5SH(05)
R83, R84: 10k; R_0402_NoSilk
R85: 180; R_0402_NoSilk
TVS10: TPD4E004; Fairchild_MicroPak-6_1.0x1.45mm_Pitch0.5mm

Connections:
+3V3: C37.2, R83.1, R85.2, TVS10.6 (VCC); also elsewhere on the board
/Debug Connector/SWD_SCHKY: D13.2 (A), R85.1
/Debug Connector/SWD_VREF: D12.1 (A1), D13.1 (K), J7.6
/SWD_RESET: J7.3, TVS10.1 (IO1); also elsewhere on the board
/SWD_SWCLK: J7.4, R84.1, TVS10.2 (IO2); also elsewhere on the board
/SWD_SWDIO: J7.5, R83.2, TVS10.4 (IO3); also elsewhere on the board
GND: C37.1, D12.2 (A2), J7.2, R84.2, TVS10.3 (GND); also elsewhere on the board

Notes on the sheet:
* Reverse plug not likely... Perhaps internal short in the debugger can happen - that's why there is a fuse
* In case of reverse plug, Vref ends up on Reset - still 3.3V, but data lines are grounded
* Zener not necessary? I am supplying the 3V3 to the debugger for level translation; overvoltage not likely
VREF
SWDIO
SWCLK
RESET
GND
SWO

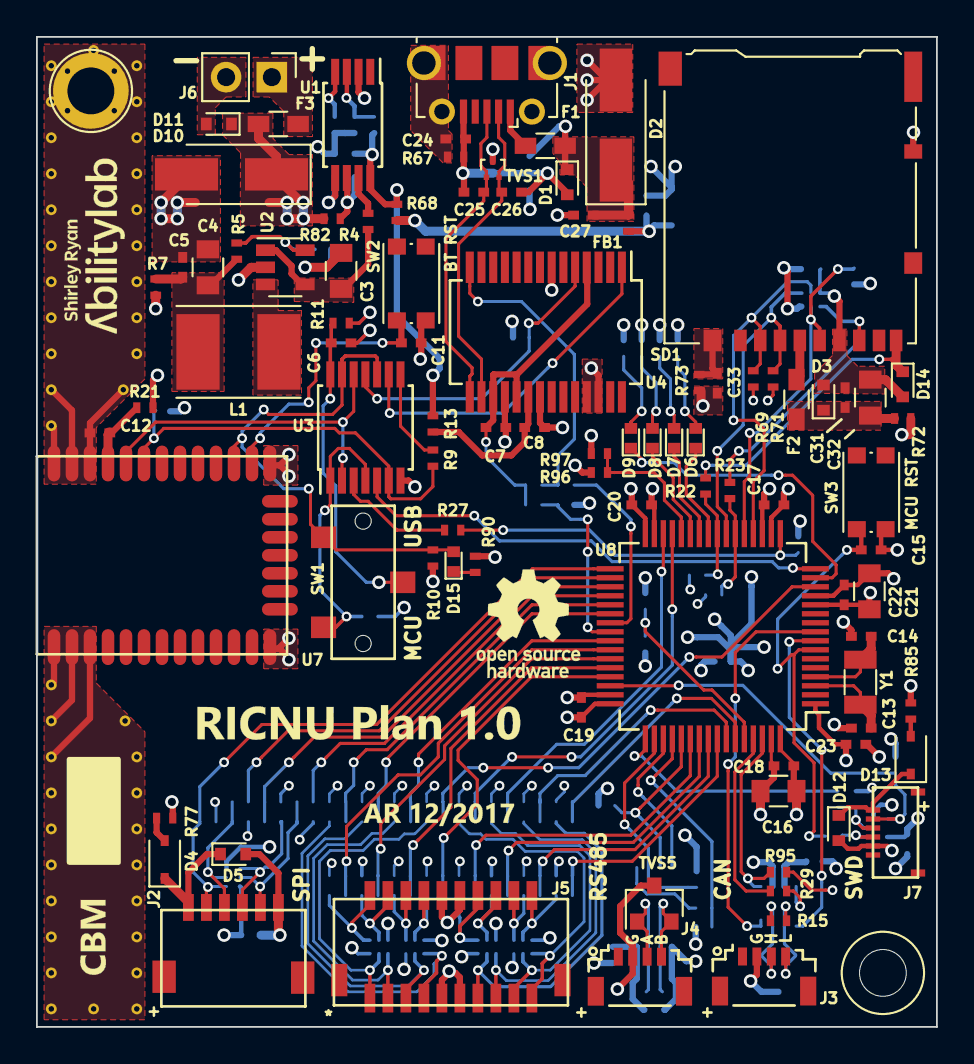
[picture p18: board RICNU_Plan_v_1_0.kicad_pcb from above]

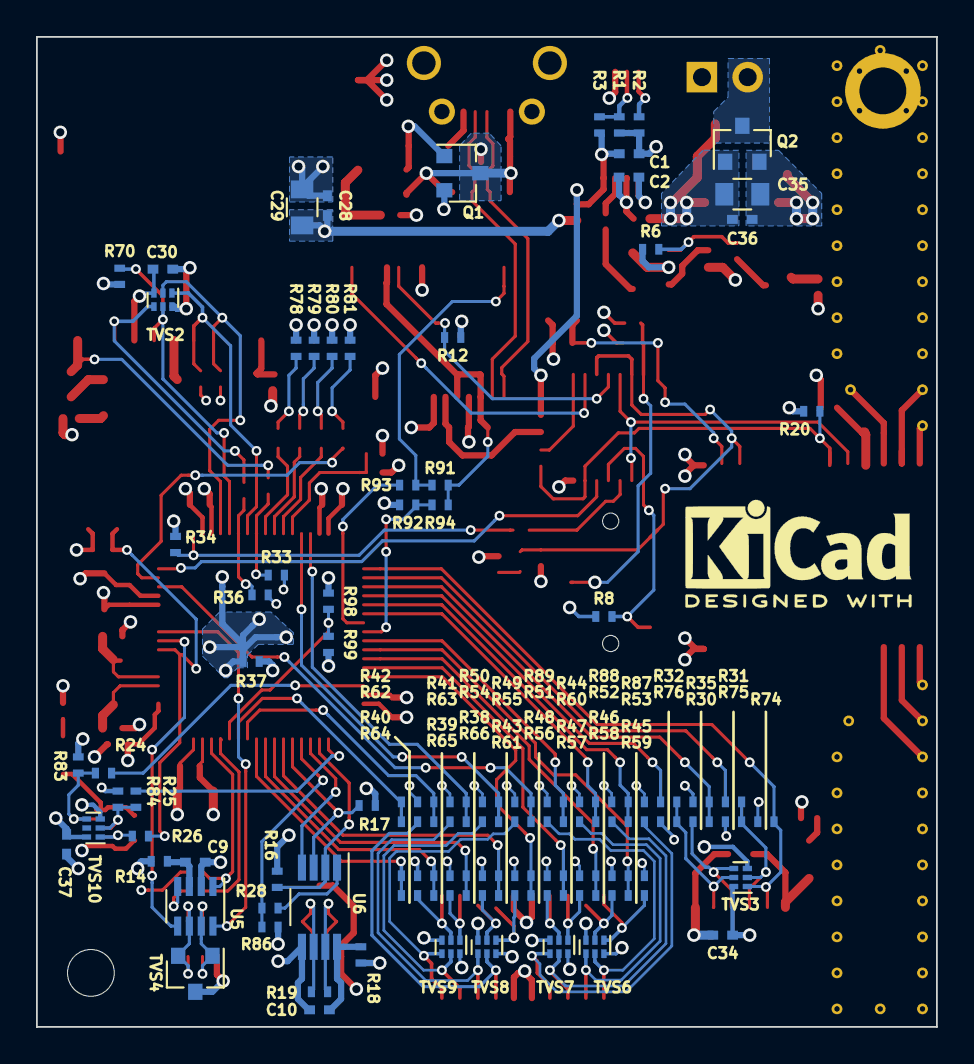
[picture p19: board RICNU_Plan_v_1_0.kicad_pcb from below]

Board: 4 copper layers, 50.0 x 55.0 mm, 188 parts (96 on the bottom side), 128 nets.
