AlexeyRevinski/RICNU_HLCI_board/(commit log)

2017-11-28 First commit - board almost routed
    [_saved_RICNU_Plan_v_1_0_ManageConn.sch, todo.sch]
2017-11-29 All nets connected, silkscreen done, via sizes checked
    [RICNU_Plan_v_1_0.kicad_pcb, RICNU_Plan_v_1_0.sch, RICNU_Plan_v_1_0_5VInput.sch, RICNU_Plan_v_1_0_Bluetooth.sch, RICNU_Plan_v_1_0_Breakout.sch, RICNU_Plan_v_1_0_Buck.sch, RICNU_Plan_v_1_0_CAN.sch, RICNU_Plan_v_1_0_CAN_Conn.sch]
2017-11-29 Re-routed CAN, RS-485, and debug connectors (wrong polarity in all)
    [RICNU_Plan_v_1_0.kicad_pcb, RICNU_Plan_v_1_0.sch, RICNU_Plan_v_1_0_5VInput.sch, RICNU_Plan_v_1_0_Bluetooth.sch, RICNU_Plan_v_1_0_CAN_Conn.sch, RICNU_Plan_v_1_0_IO_Conn.sch, RICNU_Plan_v_1_0_LED.sch, RICNU_Plan_v_1_0_MCU.sch]
2017-12-01 Added connections to monitor power, changed CANSTB MCU pin, moved LED pins around
    [RICNU_Plan_v_1_0.kicad_pcb, RICNU_Plan_v_1_0.sch, RICNU_Plan_v_1_0_5VInput.sch, RICNU_Plan_v_1_0_CAN_Conn.sch, RICNU_Plan_v_1_0_IO_Conn.sch, RICNU_Plan_v_1_0_LED.sch, RICNU_Plan_v_1_0_MCU.sch, RICNU_Plan_v_1_0_Manage.sch]
2017-12-04 had to relocate 4.7uF cap for STM32 based on datasheet info. Experimenting with reset button location
    [RICNU_Plan_v_1_0.kicad_pcb, RICNU_Plan_v_1_0_5VInput.sch, RICNU_Plan_v_1_0_Bluetooth.sch, RICNU_Plan_v_1_0_CAN.sch, RICNU_Plan_v_1_0_CAN_Conn.sch, RICNU_Plan_v_1_0_IO_Conn.sch, RICNU_Plan_v_1_0_LED.sch, RICNU_Plan_v_1_0_MCU.sch]
2017-12-06 Design freeze - ordered the board
    [RICNU_Plan_v_1_0.kicad_pcb, RICNU_Plan_v_1_0.sch, RICNU_Plan_v_1_0_5VInput.sch, RICNU_Plan_v_1_0_CAN_Conn.sch, RICNU_Plan_v_1_0_IO_Conn.sch, RICNU_Plan_v_1_0_LED.sch, RICNU_Plan_v_1_0_MCU.sch, RICNU_Plan_v_1_0_Manage.sch]
2018-02-20 Various small changes like comment removal
    [RICNU_Plan_v_1_0.kicad_pcb, RICNU_Plan_v_1_0_5VInput.sch, RICNU_Plan_v_1_0_Bluetooth.sch, RICNU_Plan_v_1_0_LED.sch, RICNU_Plan_v_1_0_MCU.sch, RICNU_Plan_v_1_0_Power.sch, RICNU_Plan_v_1_0_SDCard.sch, RICNU_Plan_v_1_0_SWD.sch]
2018-03-22 Deleting PDFs
    [RICNU_Plan_v_1_0.sch, RICNU_Plan_v_1_0_Bluetooth.sch, RICNU_Plan_v_1_0_CAN.sch, RICNU_Plan_v_1_0_IO_Conn.sch, RICNU_Plan_v_1_0_Manage.sch, RICNU_Plan_v_1_0_Power.sch, RICNU_Plan_v_1_0_RS485.sch, RICNU_Plan_v_1_0_SWD.sch]
